pzfreo/pegturner/README.md

# pegturner

A build123d codebase to make a cello peg turning tool
