pzfreo/pegturner/plate.3mf

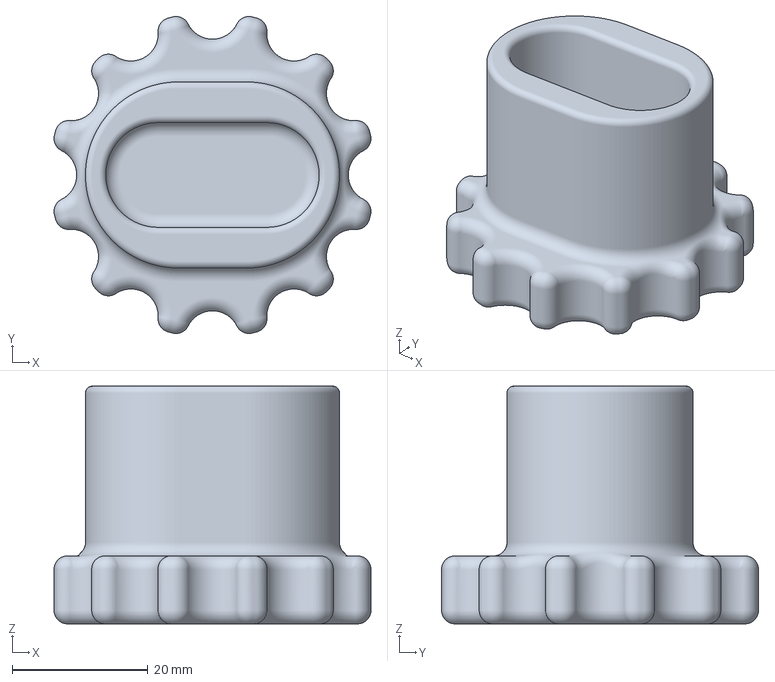
[picture p1: CAD file, 2026-03-17]
plate.3mf
46.7 x 46.7 x 35.0 mm
