pzfreo/pegturner/peg_turner_wi.3mf

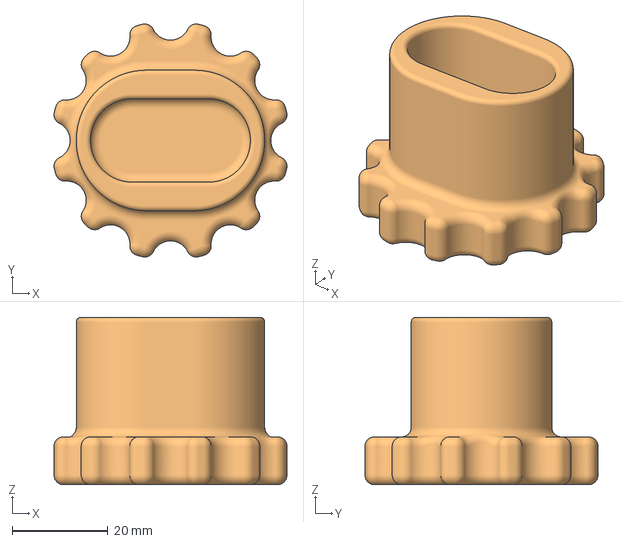
[picture p2: CAD file, 2026-03-14]
peg_turner_wi.3mf
48.7 x 48.7 x 35.0 mm
inlay
