pzfreo/pegturner/peg_insert.3mf

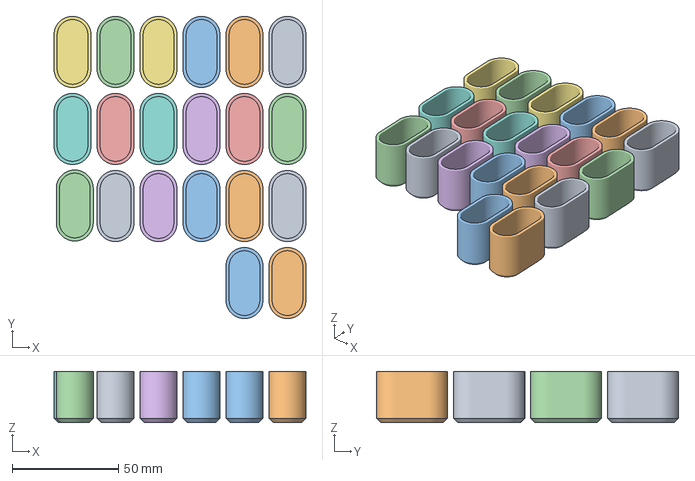
[picture p3: CAD file, 2026-03-13]
peg_insert.3mf
118.4 x 142.0 x 24.0 mm
peg_insert.step x 20
