pzfreo/pegturner/(list of files, cad)

Other CAD files:
output/plate_sliced.gcode.3mf
