pzfreo/pegturner/(commit log)

2026-03-09 Add peg turner 3D model and specification
    Build123d Python script that generates a cylindrical peg turner for cello pegs,
    with internal slot socket, 12 external scallops, and STEP file export.
    [peg_turner.step]
2026-03-09 Add rounded slot corners and chamfered scallop edges
    Slot now has stadium-shaped rounded ends for smoother peg insertion.
    Scallop cut edges are chamfered (0.8mm) to remove sharp edges.
    [peg_turner.step]
2026-03-09 Chamfer all scallop edges including top/bottom faces
    Broadened edge filter to catch all 72 scallop-related edges (vertical
    curves plus intersections with top and bottom faces).
    [peg_turner.step]
2026-03-09 Redesign as mushroom shape to avoid jamming adjacent pegs
    Narrow stalk (35mm OD, 25mm) holds the peg socket and fits between
    adjacent pegs. Wide solid cap (45mm OD, 10mm) with scalloped grip
    sits above, providing leverage without interference.
    [peg_turner.step]
2026-03-10 Add dimension printout and parameterize stalk/cap derivation
    Print all dimensions and bounding box when script runs. Rename
    STALK_HEIGHT to PEG_HEAD_DEPTH. Update peg head dimensions to
    31mm diameter and 15mm thickness.
    [peg_turner.step]
2026-03-10 Change stalk from cylinder to stadium shape to save material
    Stalk now follows the slot profile with configurable end wall (3mm)
    and side wall (6mm) thicknesses. Reduces plastic usage and weight
    while maintaining structural strength.
    [peg_turner.step]
2026-03-10 Add fillets at stalk-cap junction for strength
    Exterior fillet (2mm) smooths the stalk-to-cap step. Interior fillet
    (2mm) reinforces the slot ceiling where it meets the solid cap.
    Reduces stress concentration under torque loads.
    [peg_turner.step]
2026-03-10 Add fabprint config for printing on Bambu Lab P1S
    ABS filament on AMS slot 3, 0.20mm standard process,
    high temp plate, cap-down orientation via Bambu Connect.
2026-03-10 Update fabprint config: 100% infill, outer brim, textured PEI plate
    Small structural part under torque needs full infill. Outer brim
    for ABS bed adhesion on textured PEI plate.
2026-03-10 Switch to ASA filament on AMS slot 2
2026-03-10 Restore vertical scallop chamfers with extended scallop cuts
    Extend scallop cylinders 1mm past both cap ends so vertical edges
    pass cleanly through the fillet zone. This also gives the stalk end
    of the scallops natural rounded transitions from the fillet.
    [peg_turner.step]
2026-03-10 Replace scallop chamfers with fillets for smooth grip
    All scallop edges (top face and vertical) are now filleted in a
    single pass for a consistently smooth, rounded grip feel.
    [peg_turner.step]
2026-03-10 Add stalk base fillet and increase scallop fillet to 2mm
    Bottom corners of stalk now filleted (1mm) for smooth peg insertion.
    Scallop fillet increased from 0.8mm to 2mm to match the shoulder
    fillet for a consistent rounded grip feel.
    [peg_turner.step]
2026-03-10 Add fillet at slot-stalk base junction for smooth peg entry
    Interior slot edges at the stalk bottom opening are now filleted,
    easing peg head insertion and strengthening the junction.
    [peg_turner.step]
2026-03-10 Add recessed 'Chelli' text to cap top face using Mrs Saint Delafield font
    Text is debossed 0.6mm into the top face of the cap. No supports needed
    as the recess faces down on the print bed (cap-down orientation).
    Includes MrsSaintDelafield-Regular.ttf font file.
    [peg_turner.step]
2026-03-10 Auto-size bold Chelli text to 75% of cap diameter
    Font auto-scales to fill 75% of cap width (~19.9mm). Uses FontStyle.BOLD
    for better legibility when recessed. fabprint.toml updated with cloud-bridge
    printer mode, serial number, rectilinear infill and cap-down orientation.
    [peg_turner.step]
2026-03-10 Fix text size to 16mm to fit within scalloped cap area
    [peg_turner.step]
2026-03-10 Switch to PETG-CF filament on AMS slot 3
2026-03-11 Add optional TPU protective insert for peg socket
    - Add --tpu-insert CLI flag to generate enlarged slot + TPU cup insert
    - Insert is a 2mm-walled cup that glues into the slot, protecting the peg
    - Slot enlarged by 1mm/side when flag is active, insert 1mm shorter to sit recessed
    - Interference check validates insert fits cleanly in the slot
    - Both parts shown in OCP viewer with distinct colours
    - Increase text emboss depth from 0.6mm to 1.0mm
    - Add fabprint-insert.toml for slicing the TPU insert (AMS slot 1)
    [peg_insert.step, peg_turner.step]
2026-03-11 toml updates
    [peg_insert.3mf, peg_insert.step, peg_turner.step, plate_sliced.gcode.3mf]
2026-03-11 update slicer slots
2026-03-11 Use distinct STEP filename for with-insert variant
    Export main body as peg_turner_wi.step when --tpu-insert is used,
    keeping peg_turner.step for the standard build. Add fabprint-wi.toml
    for slicing the with-insert variant.
    [peg_turner.step, peg_turner_wi.step]
2026-03-13 Reduce insert wall thickness and remove insert-to-slot tolerance
    INSERT_WALL 2.0 → 1.5mm, INSERT_TOLERANCE 0.2 → 0.0mm.
    First print showed the insert was loose in the slot and too tight
    over the peg head. Thinner walls give the peg 1mm more room per
    axis; zero tolerance gives a friction fit in the slot.
    [peg_insert.step, peg_turner_wi.step]
2026-03-13 Add 3MF export with text inlay + body for multi-color printing
    Export a 3MF containing two mesh objects (inlay and body) in
    print-ready orientation (cap down). The inlay fills the engraved
    text recess and prints first, allowing a filament change for
    contrasting color text.
    Also: default to --tpu-insert, export flipped body/inlay STEP
    files, and update fabprint tomls to use 3MF (no rotate needed).
    [peg_insert.3mf, peg_insert.step, peg_turner.step, peg_turner_body.step, peg_turner_inlay.step, peg_turner_wi.step, peg_turner_wi_body.step, peg_turner_wi_inlay.step]
2026-03-13 Add per-object filament config for inlay print
    Map the "inlay" object in peg_turner_wi.3mf to PLA while the
    body defaults to PETG-CF, using fabprint's new [parts.filaments].
2026-03-13 Add inlay-to-body interference check and regenerate outputs
    Verify text inlay does not overlap with turner body before
    exporting 3MF, matching the existing insert interference check.
    [peg_insert.step, peg_turner_wi.step, peg_turner_wi_body.step, peg_turner_wi_inlay.step, plate_sliced.gcode.3mf]
2026-03-14 Switch to single-layer PLA inlay for AMS multi-color printing
    Reduce TEXT_DEPTH from 1.0mm to 0.2mm (one layer) so the inlay prints
    simultaneously with the body via AMS filament swap on the first layer,
    avoiding the issue where sequential object printing disturbed the inlay
    text. Switch material from PETG-CF to PLA and configure AMS slots
    (white PLA slot 1 for inlay, black PLA slot 4 for body). Fix slicer
    profile references from X1C to P1S.
    [peg_insert.step, peg_turner_wi.step, peg_turner_wi_body.step, peg_turner_wi_inlay.step]
2026-03-14 Add CLI parameters for text, font URL, and font size
    Add --text, --font, and --text-size CLI arguments to allow customizing
    the embossed text without editing the script. The --font flag accepts a
    URL to a .ttf file which is downloaded automatically. The --text flag
    supports \n for multi-line text, rendered with centered line spacing.
    [peg_insert.step, peg_turner_wi.3mf, peg_turner_wi.step, peg_turner_wi_body.step, peg_turner_wi_inlay.step]
2026-03-14 Add --engrave and --engrave-depth CLI options for V-groove text
    Add engrave mode as an alternative to inlay for single-color prints.
    Uses a tapered extrusion (V-groove) so the engraved text is
    self-supporting when printed cap-down. Attempts 45° taper first, then
    progressively reduces to 30°/20°/10° if thin strokes collapse, falling
    back to straight walls as a last resort. Engrave mode exports a
    single-object 3MF (no inlay needed).
    [peg_insert.step, peg_turner_wi.step, peg_turner_wi_body.step, peg_turner_wi_inlay.step]
2026-03-14 Add --inlay-depth CLI option for configurable inlay recess depth
    Allows setting the inlay depth via CLI (default 0.2mm) so users can
    increase it for better slicer resolution with thin fonts.
    [peg_insert.step, peg_turner_wi.step, peg_turner_wi_body.step, peg_turner_wi_inlay.step]
2026-03-14 line spacing
    [peg_insert.step, peg_turner_wi.step, peg_turner_wi_body.step, peg_turner_wi_inlay.step, plate.3mf, plate_sliced.gcode.3mf]
2026-03-14 Extract magic numbers to named constants and update defaults
    Move all magic numbers to named constants at the top:
    - INSERT_HEIGHT_INSET, LINE_SPACING_FACTOR, ENGRAVE_TAPER_ANGLES
    - MESH_LINEAR_DEFLECTION, MESH_ANGULAR_DEFLECTION
    - INLAY_LINEAR_DEFLECTION, INLAY_ANGULAR_DEFLECTION
    Update defaults to match current usage:
    - --text "Chelli\nStrings", --text-size 12, --engrave on, --engrave-depth 0.8
    - Add --no-engrave flag via BooleanOptionalAction
    Fix stale comment referencing old INSERT_WALL value.
2026-03-14 Update fabprint-wi.toml: PETG-CF slot 3, engrave-only STEP, no brim
2026-03-14 Generate multiple TPU inserts with variable side wall thickness
    Add --insert-side-extras parameter to generate inserts with different
    side wall thicknesses (default: 1.5, 2.0, 2.5mm) while keeping the
    same outer dimensions and end/ceiling wall thickness.
    Also add .gitignore for *.3mf and .DS_Store files.
    [peg_insert.step, peg_insert_1_5.step, peg_insert_2_0.step, peg_insert_2_5.step, peg_turner_wi.step, peg_turner_wi_body.step, peg_turner_wi_inlay.step]
2026-03-14 Multi-insert generation, TPU print config, and infill optimisation
    - Generate multiple TPU inserts with variable side wall thickness
    (--insert-side-extras, default: 1.5/2.0/2.5mm side walls)
    - Add fabprint-inserts.toml for printing 2.0 and 2.5mm inserts in TPU
    - Switch body infill from 100% rectilinear to 50% gyroid with 4 walls
    - Add .gitignore for *.3mf and .DS_Store
2026-03-14 Fix insert orientation in OCP viewer to match flipped body
2026-03-17 fp update
    [plate.3mf, plate_sliced.gcode.3mf]
2026-03-18 Clean up project structure and add CI build/slice workflow
    - Gitignore generated artifacts (*.step, *.3mf, *.gcode, output/)
    - Remove tracked artifacts and obsolete files (debug.txt, profiles.list,
    wi-3mf.png, fabprint-insert.toml)
    - Remove deprecated mode field from printer configs
    - Add GitHub Actions workflow: build123d generates CAD models, then
    fabprint action slices body and inserts
    [peg_insert.step, peg_insert_1_5.step, peg_insert_2_0.step, peg_insert_2_5.step, peg_turner.step, peg_turner_body.step, peg_turner_inlay.step, peg_turner_wi.step]
2026-03-18 Build only with-insert variant in CI
2026-06-11 Update CI actions to node24-runtime versions (#22)
    * Update CI actions to node24-runtime versions
    GitHub is retiring the node20 actions runtime; checkout@v4,
    setup-python@v5, upload-artifact@v4 and download-artifact@v4 all run
    on it. Bump to the current majors (v6/v6/v7/v8); upload v7 and
    download v8 are a compatible artifact pair. The fabprint action
    already tracks @main and is unchanged.
    * Declare slicer.version in fabprint configs
    The fabprint action now requires slicer.version in the config (or a
    slicer-version input) and fails at startup without it — main has
    been red since March. Pin OrcaSlicer 2.3.1, the version used by the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
